neilogd/4op_drum_synth/hardware/4op_drum_module.kicad_pcb

## KiCad design hardware/4op_drum_module.kicad_pcb (2019-09-03)

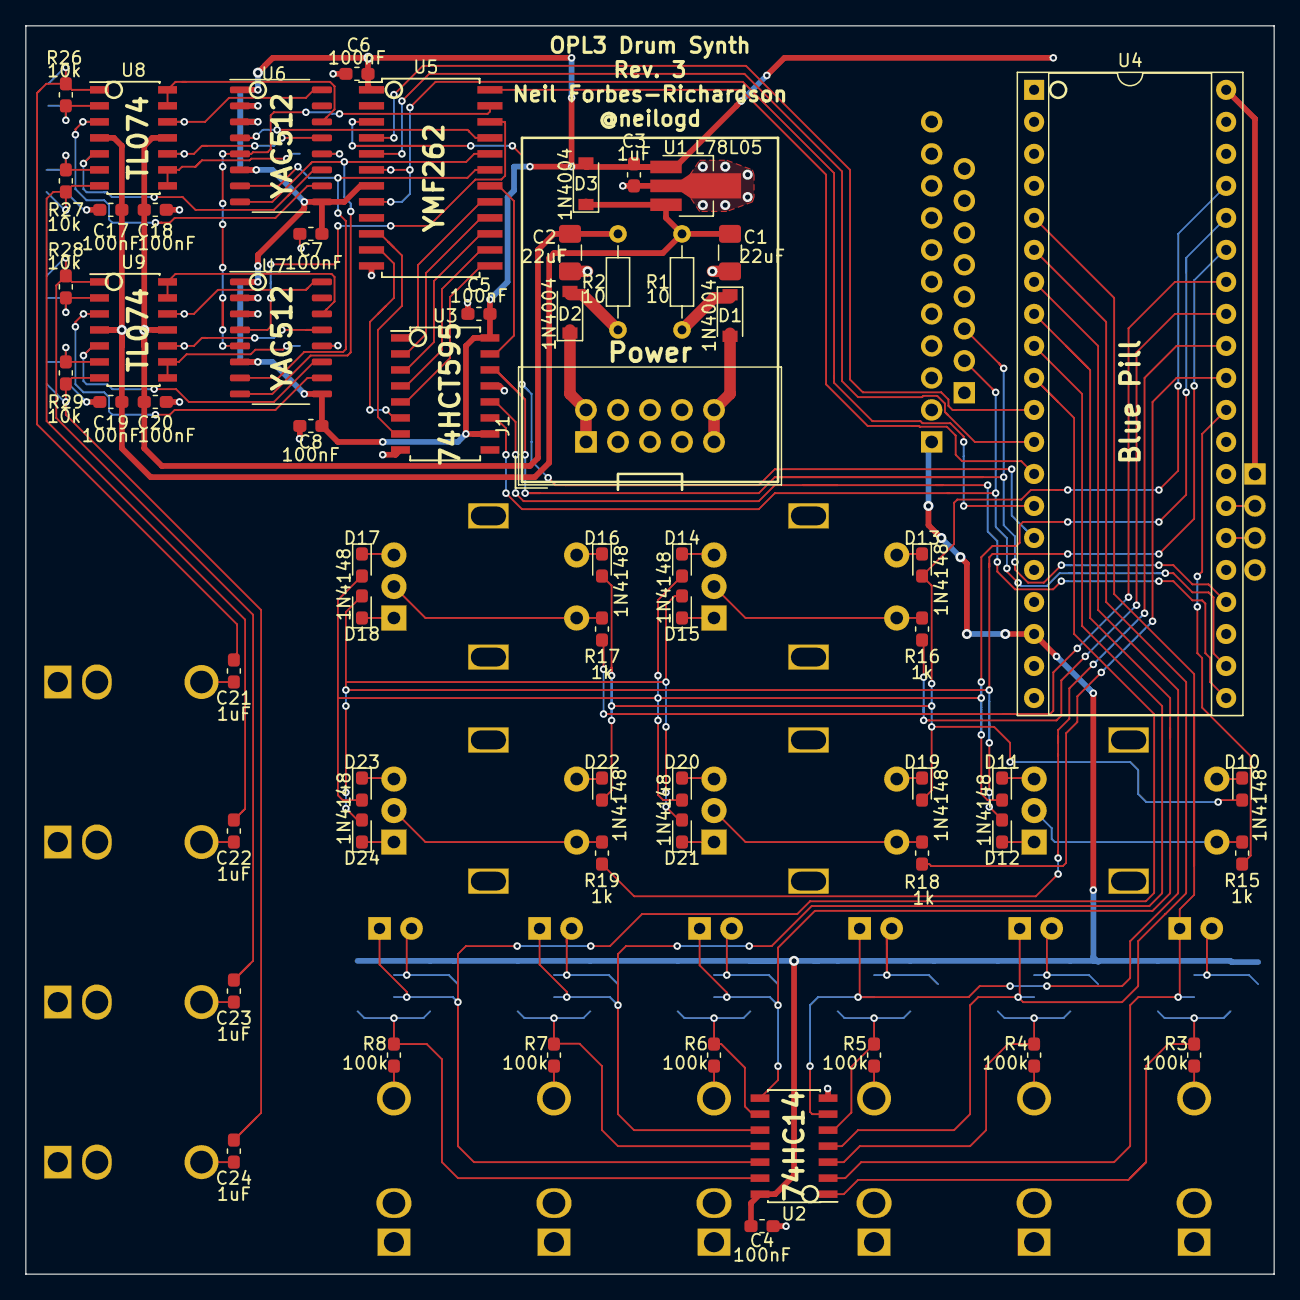
[picture p1: board 4op_drum_module.kicad_pcb from above]

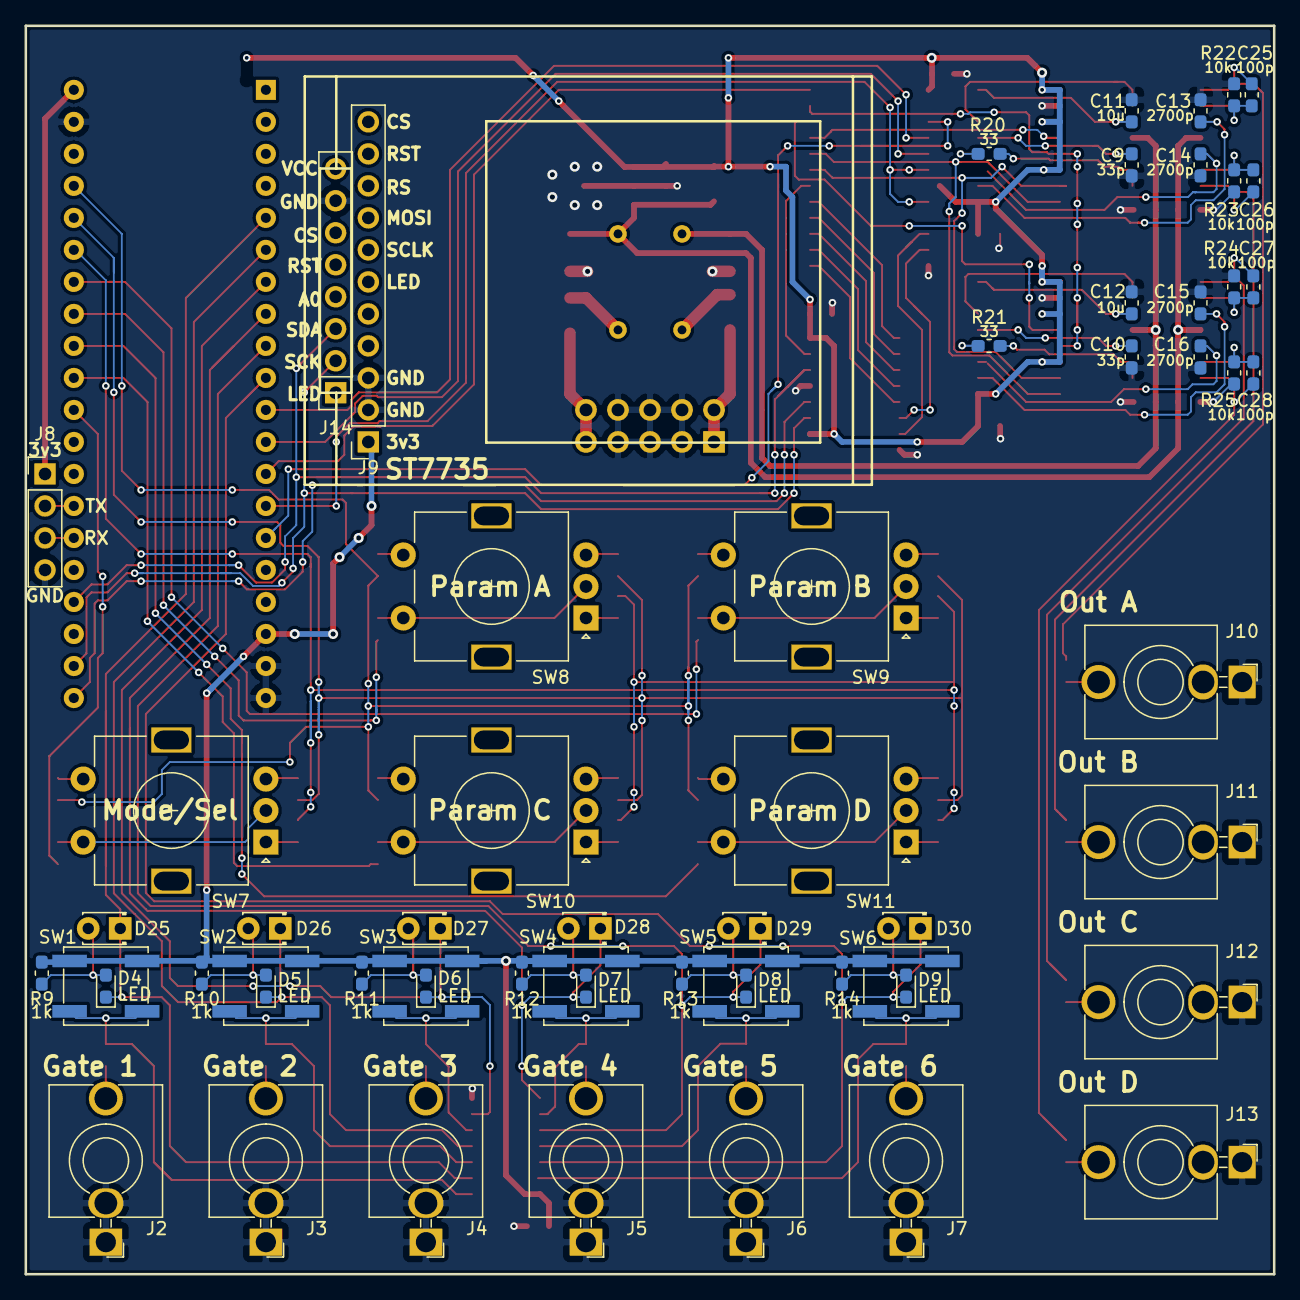
[picture p2: board 4op_drum_module.kicad_pcb from below]

Board: 2 copper layers, 99.1 x 99.1 mm, 121 parts (60 on the bottom side), 113 nets.

Parts:
C1, C2: 22uF; C_1206_3216Metric_Pad1.42x1.75mm_HandSolder
C3, C21, C22, C23, C24: 1uF; C_0603_1608Metric_Pad1.05x0.95mm_HandSolder
C4, C5, C6, C7, C8, C17, C18, C19, C20: 100nF; C_0603_1608Metric_Pad1.05x0.95mm_HandSolder
C9, C10: 33p; C_0603_1608Metric_Pad1.05x0.95mm_HandSolder
C11, C12: 10u; C_0603_1608Metric_Pad1.05x0.95mm_HandSolder
C13, C14, C15, C16: 2700p; C_0603_1608Metric_Pad1.05x0.95mm_HandSolder
C25, C26, C27, C28: 100p; C_0603_1608Metric_Pad1.05x0.95mm_HandSolder
D1, D2, D3: 1N4004; D_SOD-123
D4, D5, D6, D7, D8, D9: LED; LED_0603_1608Metric_Pad1.05x0.95mm_HandSolder
D10, D11, D12, D13, D14, D15, D16, D17, D18, D19, D20, D21, D22, D23, D24: 1N4148; D_0603_1608Metric_Pad1.05x0.95mm_HandSolder
D25, D26, D27, D28, D29, D30: LED; LED_D1.8mm_W3.3mm_H2.4mm
J1: Conn_02x05_Eurorack; IDC-Header_2x05_P2.54mm_Vertical
J2, J3, J4, J5, J6, J7, J10, J11, J12, J13: Jack; Jack_3.5mm_QingPu_WQP-PJ398SM_Vertical_CircularHoles_TS
J8: Conn_01x04_Male; PinHeader_1x04_P2.54mm_Vertical
J9: Conn_01x11_Female; PinSocket_1x11_P2.54mm_Vertical
J14: Conn_01x08_Female; PinSocket_1x08_P2.54mm_Vertical
R1, R2: 10; R_Axial_DIN0204_L3.6mm_D1.6mm_P7.62mm_Horizontal
R3, R4, R5, R6, R7, R8: 100k; R_0603_1608Metric_Pad1.05x0.95mm_HandSolder
R9, R10, R11, R12, R13, R14, R15, R16, R17, R18, R19: 1k; R_0603_1608Metric_Pad1.05x0.95mm_HandSolder
R20, R21: 33; R_0603_1608Metric_Pad1.05x0.95mm_HandSolder
R22, R23, R24, R25, R26, R27, R28, R29: 10k; R_0603_1608Metric_Pad1.05x0.95mm_HandSolder
SW1, SW2, SW3, SW4, SW5, SW6: SW_Push; SW_SPST_EVQP0
SW7, SW8, SW9, SW10, SW11: Rotary; RotaryEncoder_Alps_EC11E-Switch_Vertical_H20mm
U1: L78L05; SOT-89-3_Handsoldering
U2: 74HC14; SOIC-14_3.9x8.7mm_P1.27mm
U3: 74HCT595; SOIC-16W_5.3x10.2mm_P1.27mm
U4: BluePill_STM32F103C; DIP-40_W15.24mm_Socket
U5: YMF262; SOIC-24W_7.5x15.4mm_P1.27mm
U6, U7: YAC512; SOIC-16_4.55x10.3mm_P1.27mm
U8, U9: TL074; SOIC-14_3.9x8.7mm_P1.27mm

Connections:
+3V3: C4.1, J8.1, J9.1, J9.6, J14.1, J14.8, R9.1, R10.1, R11.1, R12.1, R13.1, R14.1, SW1.1, SW2.1, SW3.1, SW4.1, SW5.1, SW6.1, U2.14, U4.18, U4.40
+5V: C3.1, C5.1, C6.1, C7.1, C8.1, D3.2, U1.1, U3.10, U3.16, U4.38, U5.1, U5.7, U6.1, U6.3, U6.6, U6.9, U7.1, U7.3, U7.6, U7.9
+12V: C1.1, C17.1, C19.1, D3.1, R1.2, U1.3, U8.4, U9.4
-12V: C2.2, C18.2, C20.2, R2.2, U8.11, U9.11
A0: U4.11, U5.4
A1: U4.12, U5.5
AOUT1: C9.1, U6.13, U8.10
AOUT2: C10.1, U7.13, U9.10
CH1: C13.1, U6.10, U8.3
CH2: C14.1, U6.11, U8.5
CH3: C15.1, U7.10, U9.3
CH4: C16.1, U7.11, U9.5
CLK: U4.13, U5.24
CS: U4.14, U5.6, U5.8
CV1: C11.1, U6.16, U8.12
CV2: C12.1, U7.16, U9.12
D0: U3.7, U5.10
D1: U3.6, U5.11
D2: U3.5, U5.13
D3: U3.4, U5.14
D4: U3.3, U5.15
D5: U3.2, U5.16
D6: U3.1, U5.17
D7: U3.15, U5.18
G0: D4.1, D25.1, U2.2, U4.5
G1: D5.1, D26.1, U2.4, U4.6
G2: D6.1, D27.1, U2.6, U4.7
G3: D7.1, D28.1, U2.8, U4.8
G4: D8.1, D29.1, U2.10, U4.9
G5: D9.1, D30.1, U2.12, U4.10
GND: C1.2, C2.1, C3.2, C4.2, C5.2, C6.2, C7.2, C8.2, C9.2, C10.2, C11.2, C12.2, C13.2, C14.2, C15.2, C16.2, C17.2, C18.1, C19.2, C20.1, J1.3, J1.4, J1.5, J1.6, J1.7, J1.8, J2.1, J2.3, J3.1, J3.3, J4.1, J4.3, J5.1, J5.3, J6.1, J6.3, J7.1, J7.3, J8.4, J9.2, J9.3, J10.1, J11.1, J12.1, J13.1, J14.7, R22.1, R23.1, R24.1, R25.1, U1.2, U2.7, U3.8, U3.13, U4.19, U4.20, U4.39, U5.12, U6.2, U7.2
LED_CS: J9.11, J14.6, U4.2
LED_RS: J9.9, J14.4, U4.4
LED_RST: J9.10, J14.5, U4.3
MOSI: J9.8, J14.3, U3.14, U4.24
MP1: U6.14, U8.13, U8.14
MP2: U7.14, U9.13, U9.14
NSS: U3.12, U4.21
unnamed: C21.1, C25.1, R26.1, U8.1
unnamed: C21.2, J10.2
unnamed: C22.1, C26.1, R27.1, U8.7
unnamed: C22.2, J11.2
unnamed: C23.1, C27.1, R28.2, U9.1
unnamed: C23.2, J12.2
unnamed: C24.1, C28.1, R29.1, U9.7
unnamed: C24.2, J13.2
unnamed: C25.2, R22.2, R26.2, U8.2
unnamed: C26.2, R23.2, R27.2, U8.6
unnamed: C27.2, R24.2, R28.1, U9.2
unnamed: C28.2, R25.2, R29.2, U9.6
unnamed: D1.1, R1.1
unnamed: D1.2, J1.9, J1.10
unnamed: D2.1, J1.1, J1.2
unnamed: D2.2, R2.1
unnamed: D10.1, SW7.S1
unnamed: D11.1, SW7.B
unnamed: D12.1, SW7.A
unnamed: D13.1, SW8.S1
unnamed: D14.1, SW8.B
unnamed: D15.1, SW8.A
unnamed: D16.1, SW9.S1
unnamed: D17.1, SW9.B
unnamed: D18.1, SW9.A
unnamed: D19.1, SW10.S1
unnamed: D20.1, SW10.B
unnamed: D21.1, SW10.A
unnamed: D22.1, SW11.S1
unnamed: D23.1, SW11.B
unnamed: D24.1, SW11.A
unnamed: D4.2, D25.2, R9.2
unnamed: D5.2, D26.2, R10.2
unnamed: D6.2, D27.2, R11.2
unnamed: D7.2, D28.2, R12.2
unnamed: D8.2, D29.2, R13.2
unnamed: D9.2, D30.2, R14.2
unnamed: J2.2, R3.1
unnamed: J3.2, R4.1
unnamed: J4.2, R5.1
unnamed: J5.2, R6.1
unnamed: J6.2, R7.1
unnamed: J7.2, R8.1
unnamed: J8.2, U4.27
unnamed: J8.3, U4.26
unnamed: R3.2, SW1.2, U2.1
unnamed: R4.2, SW2.2, U2.3
unnamed: R5.2, SW3.2, U2.5
unnamed: R6.2, SW4.2, U2.9
unnamed: R7.2, SW5.2, U2.11
unnamed: R8.2, SW6.2, U2.13
unnamed: R15.1, SW7.C, SW7.S2
unnamed: R16.1, SW8.C, SW8.S2
unnamed: R17.1, SW9.C, SW9.S2
unnamed: R18.1, SW10.C, SW10.S2
unnamed: R19.1, SW11.C, SW11.S2
unnamed: R20.2, U6.12
unnamed: R21.2, U7.12
unnamed: U5.19, U6.7, U7.7
unnamed: U5.20, U6.8, U7.8
unnamed: U5.21, U6.4
unnamed: U5.22, U7.4
unnamed: U5.23, U6.5, U7.5
RST: U4.15, U5.3
R_C0: R15.2, U4.30
R_C1: R16.2, U4.33
R_C2: R17.2, U4.34
R_C3: R18.2, U4.31
R_C4: R19.2, U4.32
R_R0: D11.2, D14.2, D17.2, D20.2, D23.2, U4.36
R_R1: D12.2, D15.2, D18.2, D21.2, D24.2, U4.35
R_R2: D10.2, D13.2, D16.2, D19.2, D22.2, U4.37
SCLK: J9.7, J14.2, U3.11, U4.22
SWIN1: R20.1, U8.8, U8.9
SWIN2: R21.1, U9.8, U9.9
