neilogd/4op_drum_synth/firmware/src/icons.h

#pragma once
static const int icons_w = 16;
static const int icons_h = 256;
static const uint8_t icons_data[] = {
	0x00, 0x00, 0x00, 0x00, 0x00, 0x00, 0x00, 0x00, 0x00, 0x00, 0x00, 0x00, 0x0e, 0xe0, 0x0b, 0xb0, 0x0e, 0xe0, 0x00, 0x00, 0x00, 0x00, 0x00, 0x00, 0x00, 0x00, 0x00, 0x00, 0x00, 0x00, 0x00, 0x00, 
	0x00, 0x00, 0x00, 0x00, 0x00, 0x00, 0x00, 0x00, 0x07, 0x00, 0x05, 0xc0, 0x07, 0x40, 0x00, 0x60, 0x07, 0x40, 0x05, 0xc0, 0x07, 0x00, 0x00, 0x00, 0x00, 0x00, 0x00, 0x00, 0x00, 0x00, 0x00, 0x00, 
	0x00, 0x00, 0x00, 0x00, 0x00, 0x00, 0x00, 0x00, 0x00, 0x00, 0x00, 0x00, 0xee, 0xee, 0xbb, 0xbb, 0xee, 0xee, 0x00, 0x00, 0x00, 0x00, 0x00, 0x00, 0x00, 0x00, 0x00, 0x00, 0x00, 0x00, 0x00, 0x00, 
	0x00, 0x00, 0x00, 0x00, 0x00, 0x00, 0x00, 0x00, 0x1d, 0xc0, 0x17, 0x70, 0x1d, 0xd0, 0x00, 0x18, 0x1d, 0xd0, 0x17, 0x70, 0x1d, 0xc0, 0x00, 0x00, 0x00, 0x00, 0x00, 0x00, 0x00, 0x00, 0x00, 0x00, 
	0x00, 0x00, 0x00, 0x00, 0x38, 0x00, 0x2f, 0xfe, 0x38, 0x02, 0x00, 0x02, 0x3b, 0xba, 0x2e, 0xef, 0x3b, 0xb8, 0x00, 0x00, 0x00, 0x00, 0x00, 0x00, 0x00, 0x00, 0x00, 0x00, 0x00, 0x00, 0x00, 0x00, 
	0x00, 0x00, 0x00, 0x00, 0x1c, 0x00, 0x17, 0xf0, 0x1c, 0x10, 0x00, 0x10, 0x1d, 0xd0, 0x17, 0x78, 0x1d, 0xd0, 0x00, 0x10, 0x1c, 0x10, 0x17, 0xf0, 0x1c, 0x00, 0x00, 0x00, 0x00, 0x00, 0x00, 0x00, 
	0x00, 0x00, 0x00, 0x00, 0x18, 0x00, 0x24, 0x00, 0x42, 0x00, 0x42, 0x00, 0x81, 0x00, 0x81, 0x00, 0x00, 0x81, 0x00, 0x81, 0x00, 0x42, 0x00, 0x42, 0x00, 0x24, 0x00, 0x18, 0x00, 0x00, 0x00, 0x00, 
	0x00, 0x00, 0x00, 0x00, 0x18, 0x00, 0x24, 0x00, 0x42, 0x00, 0x42, 0x00, 0x81, 0x00, 0x81, 0x00, 0x00, 0xff, 0x00, 0x00, 0x00, 0x00, 0x00, 0x00, 0x00, 0x00, 0x00, 0x00, 0x00, 0x00, 0x00, 0x00, 
	0x00, 0x00, 0x00, 0x00, 0x18, 0x18, 0x24, 0x24, 0x42, 0x42, 0x42, 0x42, 0x81, 0x81, 0x81, 0x81, 0x00, 0x00, 0x00, 0x00, 0x00, 0x00, 0x00, 0x00, 0x00, 0x00, 0x00, 0x00, 0x00, 0x00, 0x00, 0x00, 
	0x00, 0x00, 0x00, 0x00, 0x18, 0x18, 0x28, 0x28, 0x48, 0x48, 0x48, 0x48, 0x88, 0x88, 0x88, 0x88, 0x07, 0x07, 0x00, 0x00, 0x00, 0x00, 0x00, 0x00, 0x00, 0x00, 0x00, 0x00, 0x00, 0x00, 0x00, 0x00, 
	0x00, 0x00, 0x00, 0x00, 0x00, 0x00, 0x60, 0x00, 0x90, 0x00, 0x90, 0x00, 0x90, 0x00, 0x90, 0x00, 0x09, 0xff, 0x09, 0x00, 0x09, 0x00, 0x09, 0x00, 0x06, 0x00, 0x00, 0x00, 0x00, 0x00, 0x00, 0x00, 
	0x00, 0x00, 0x00, 0x00, 0x00, 0x00, 0x66, 0x00, 0x99, 0x00, 0x99, 0x00, 0x99, 0x00, 0x99, 0x00, 0x00, 0xff, 0x00, 0x00, 0x00, 0x00, 0x00, 0x00, 0x00, 0x00, 0x00, 0x00, 0x00, 0x00, 0x00, 0x00, 
	0x00, 0x00, 0x00, 0x00, 0x00, 0x00, 0xff, 0x00, 0x81, 0x00, 0x81, 0x00, 0x81, 0x00, 0x81, 0x00, 0x00, 0x81, 0x00, 0x81, 0x00, 0x81, 0x00, 0x81, 0x00, 0xff, 0x00, 0x00, 0x00, 0x00, 0x00, 0x00, 
	0x00, 0x00, 0x00, 0x00, 0x80, 0x00, 0xe0, 0x00, 0x90, 0x00, 0x8c, 0x00, 0x82, 0x00, 0x81, 0x80, 0x00, 0x41, 0x00, 0x31, 0x00, 0x09, 0x00, 0x07, 0x00, 0x01, 0x00, 0x00, 0x00, 0x00, 0x00, 0x00, 
	0x00, 0x00, 0x00, 0x00, 0x01, 0x80, 0x02, 0x00, 0x1f, 0xf0, 0x12, 0x10, 0x11, 0x90, 0x10, 0x10, 0x10, 0x10, 0x38, 0x38, 0x10, 0x10, 0x00, 0x00, 0x00, 0x00, 0x00, 0x00, 0x00, 0x00, 0x00, 0x00, 
	0x03, 0x80, 0x0c, 0x60, 0x10, 0x10, 0x21, 0x08, 0x24, 0x48, 0x40, 0x04, 0x48, 0x24, 0x40, 0x04, 0x20, 0x08, 0x20, 0x08, 0x13, 0x90, 0x0c, 0x60, 0x00, 0x00, 0x00, 0x00, 0x00, 0x00, 0x00, 0x00, 
};
