neilogd/4op_drum_synth/firmware/src/analog_inputs.cpp

#include "analog_inputs.h"

AnalogInputs::AnalogInputs()
{
  for(int i = 0; i < MAX_INPUTS; ++i)
  {
    pins_[i] = -1;
    values_[i] = 0;
  }
}

void AnalogInputs::setInput(int idx, int pin)
{
  pins_[idx] = pin;
#if 0
  pinMode(pin, INPUT_ANALOG); 
#endif
}

int AnalogInputs::getInput(int idx) const
{
  return values_[idx];
}

void AnalogInputs::scan()
{
  static bool isInit = false;
  // TODO: Use ADC isr.
#if 0
  for(int i = 0; i < MAX_INPUTS; ++i)
  {
    if(pins_[i] != -1)
      values_[i] = analogRead(pins_[i]);
  }
#endif
}
