neilogd/4op_drum_synth/(commit log)

2019-01-21 Initisal commit.
    [4op_drum_module-B.SilkS.dxf, 4op_drum_module-F.SilkS.dxf, 4op_drum_module-Margin.dxf, 4op_drum_module.kicad_pcb, 4op_drum_module.sch, params.txt]
2019-01-24 Encoder and button config moved into config.h
2019-01-24 pow->powf, add embedded printf. Reduces binary size significantly
2019-01-24 gate more sensitive, powf fast added, but unused due to precision issues (need to look at it again)
    [config.h, firmware.ino, params.h, utils.h]
2019-01-26 Configurable rotary encoder position
2019-09-03 Stripped out old junk, added ctrlr panel (still todo)
    [4op_drum_module-B.SilkS.dxf, 4op_drum_module-F.SilkS.dxf, 4op_drum_module-Margin.dxf, params.txt]
2019-09-03 Moved kicad stuff into hardware folder
    [4op_drum_module.kicad_pcb, 4op_drum_module.sch, 4op_drum_module_rev2.kicad_pcb, backup1.kicad_pcb, panel.kicad_pcb]
2019-09-04 Added binary size dumping when building STM32
